HexabitzPlatform/H1BR7x-Hardware/README.md

# H1BR7x-Hardware
Hexabitz USB-C Mass Storage Device Module Hardware Design
