HexabitzPlatform/H1BR7x-Hardware/Released/BOM/H1BR7.xlsx

 |  | www.hexabitz.com info@hexabitz.com |  | Bill Of Materials
Customer | Hexabitz | Revision | 0
Project | Hexabitz Modules | Date | 27/12/2024
Board | USB-C Mass Storage Device (H1BR7) | Notes
Designator | Description | Manufacturer Part Number | Manufacturer | Octopart Url | Quantity
RESET | Headers & Wire Housings Unshrouded 1 POS T/H | 5-146280-1 | TE Connectivity | https://octopart.com/5-146280-1-te+connectivity+%2F+amp-40259676?r=sp | 1
PWR_EN | 2 Position Total Single Row 2.54 mm Pitch Straight Male Thru-Hole Header | M20-9990245 | HARWIN INC | https://octopart.com/m20-9990245-harwin-7492269?r=sp | 1
SWD | Conn Unshrouded Header HDR 3 POS 2.54mm Solder ST Top Entry Thru-Hole Carton | 5-146281-3 | TE Connectivity | https://octopart.com/5-146281-3-te+connectivity+%2F+amp-39745942?r=sp | 1
USB_C | CONN RCP USB3.1 TYPEC 24P SMD RA | 12401610E4#2A | Amphenol ICC | https://octopart.com/12401610e4%232a-amphenol+communications+solutions-126516878?r=sp | 1
J2 | 1.10mm Pitch microSD Memory Card Connector, Normal Mount Surface Mount | 502570-0893 | Molex | https://octopart.com/502570-0893-molex-42270318?r=sp | 1
R2 | RES SMD 0.0OHM JUMPER 1/10W 0603 | RC0603JR-070RL | YAGEO [VR] | https://octopart.com/rc0603jr-070rl-yageo-1241539?r=sp | 1
R4, R5 | Thick Film Resistors - SMD 0603 27ohms 5% AEC-Q200 | ERJ-3GEYJ270V | Panasonic | https://octopart.com/erj-3geyj270v-panasonic-55422052?r=sp | 2
R1 | Thick Film Resistors - SMD 0603 270 Ohm 5% Tol | ERJ-3GEYJ271V | Panasonic | https://octopart.com/erj-3geyj271v-panasonic-55560546?r=sp | 1
R7, R10, R11, R12 | 4.7 kOhms ±5% 0.1W, 1/10W Chip Resistor 0603 | RC0603JR-074K7L | YAGED [VA] | https://octopart.com/rc0603jr-074k7l-yageo-55458509?r=sp | 4
R3 , R6 | RES 10K Ohm 1% 0603 | RC0603FR-0710KL | Yageo | https://octopart.com/rc0603fr-0710kl-yageo-40025538?r=sp (https://octopart.com/crcw060310k0jneb-vishay+dale-46603268) | 2
C3, C4 | Multilayer Ceramic Capacitor, 47 pF, 50 V, ± 5%, C0G (NP0), 0603 [1608 Metric] | CL10C470JB8NNNC | Samsung | https://octopart.com/cl10c470jb8nnnc-samsung-9299382?r=sp | 2
C5, C6, C8, C10 | CAP CER 0.1 UF 25V 10% X7R 0603 | CL10B104KA8NNNC | Samsung Electro-Mechanics | https://octopart.com/cl10b104ka8nnnc-samsung-19831573?r=sp (https://octopart.com/c0603c104k8ractu-kemet-145075?r=sp&s=9bS9ASSwSEqMCE9KBEQZ0g) | 4
C2 | CAP CER 1 UF 16V X7R 0805 | CC0805KKX7R7BB105 | YAGEO [VA] | https://octopart.com/cc0805kkx7r7bb105-yageo-8376555?r=sp | 1
C11, C7 | CAP CER 4.7UF 16V X7R 0805 | C0805C475K4RACTU | KEMET [VA] | https://octopart.com/c0805c475k4ractu-kemet-22859922?r=sp (https://octopart.com/grm21bc81e475ka12l-murata-10331911?r=sp&s=RY3qZSD8T6mG6TC9CHI5qQ) | 2
C1, C9 | Cap Ceramic 10uF 25V X5R 10% Pad SMD 0805 | 08053D106KAT2A | AVX | https://octopart.com/08053d106kat2a-avx-71037153?r=sp | 2
FB1 | Ind chip Bead Multi-Layer 30 ohms 25% 100MHZ Ferrite 1,5A 0603Punched paper T/R | MMZ1608Y300BTA00 | TDK | https://octopart.com/mmz1608y300bta00-tdk-7906990?r=sp | 1
D1 | LED Uni-Color Super Red 639nm 2-Pin Chip 0603(1608Metric) T/R | VLMS1300-GS08 | Vishay | https://octopart.com/vlms1300-gs08-vishay-21709201?r=sp | 1
D2 | TVS DIODE 3,3V 10,9V SOD323 | CDSOD323-T03SC | Bourns | https://octopart.com/cdsod323-t03sc-bourns-10487153?r=sp | 1
U1 | MCU 32-bit ARM Cortex M0+ RISC 512KB Flash 1.8V/2.5V/3.3V 48-Pin UFQFPN EP Tray | STM32G0B1CEU6 | STMicroelectronics | https://octopart.com/stm32g0b1ceu6-stmicroelectronics-116363364?r=sp | 1
U2 | LDO Voltage Regulators 2 A high PSRR ultra low drop linear regulator reverse current protection | LD39200PU33R | STMicroelectronics | https://octopart.com/ld39200pu33r-stmicroelectronics-49646134?r=sp (https://octopart.com/max14840easa%2Bt-analog+devices-124208283?r=sp) | 1
X1 | 8,0000MHZ 33pF SMD MURATA Resonators | CSTNE8M00G550000R0 | Murata | https://octopart.com/cstne8m00g550000r0-murata-91406934?r=sp | 1
