HexabitzPlatform/H1BR7x-Hardware/Documentation/H1BR7 Schematics.pdf

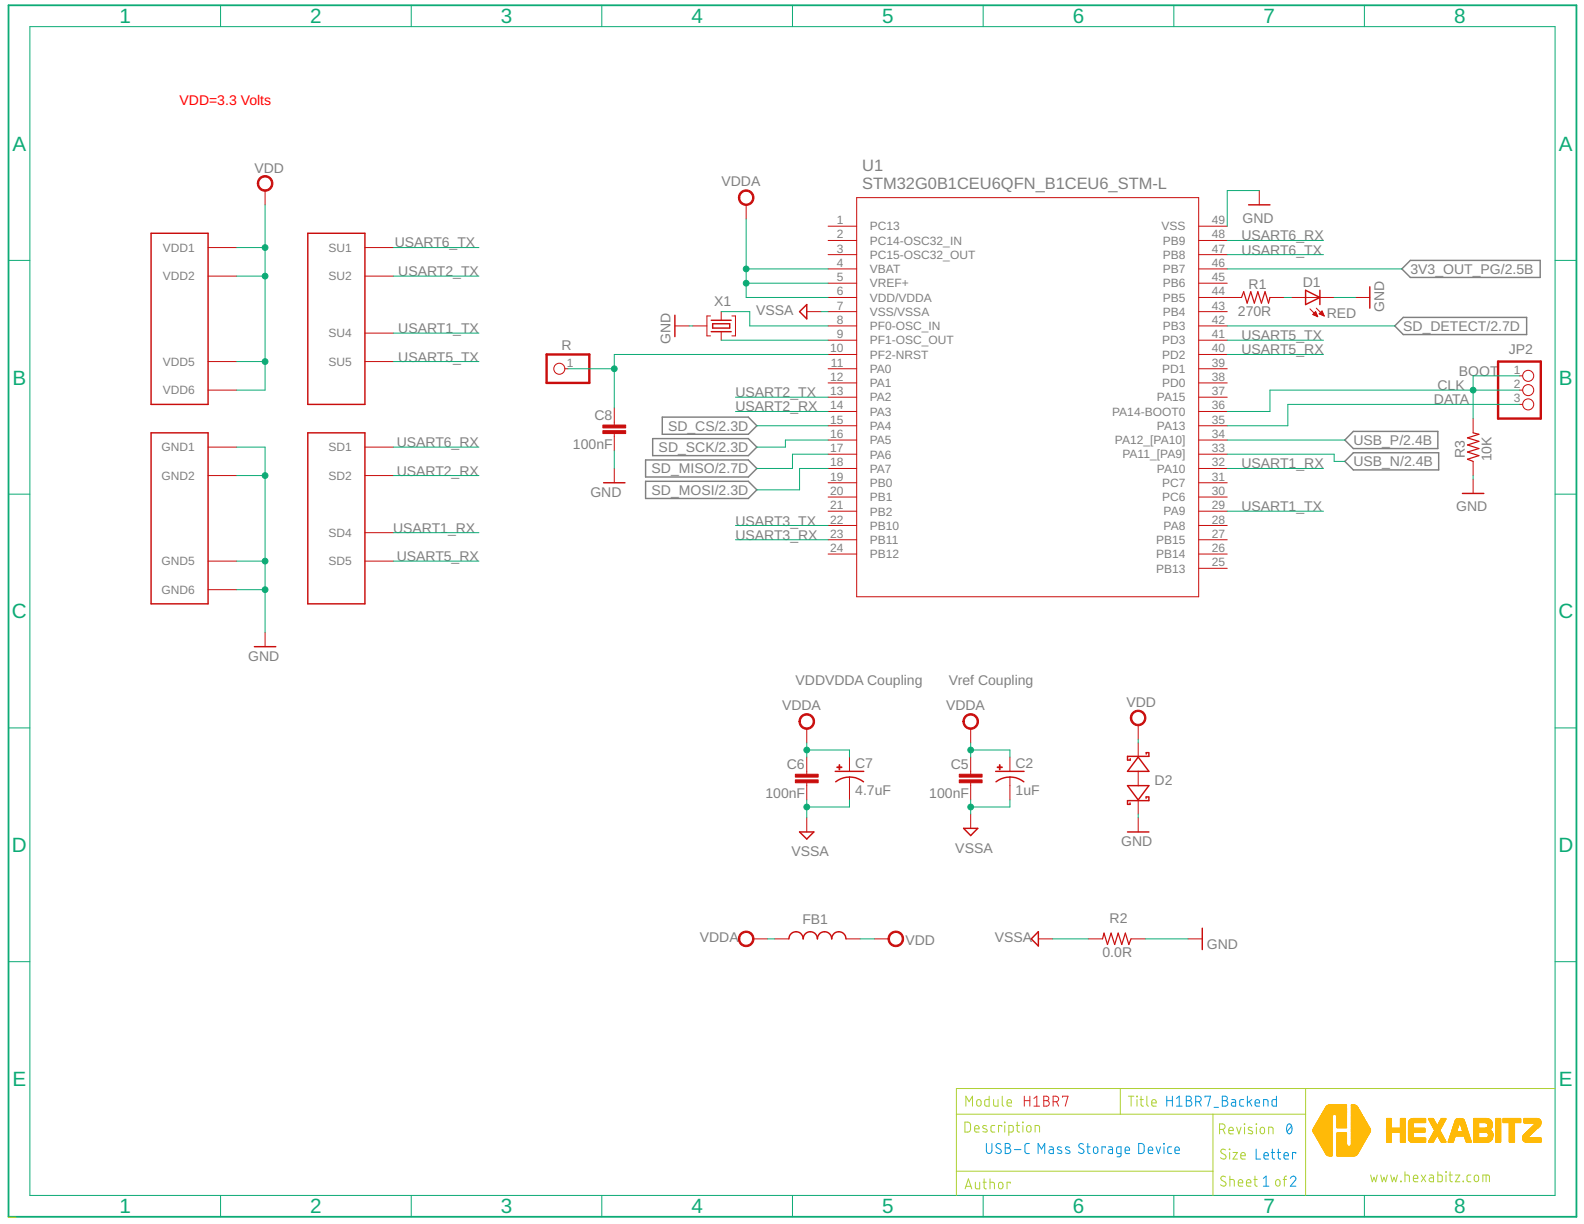
[picture p1: page 1]

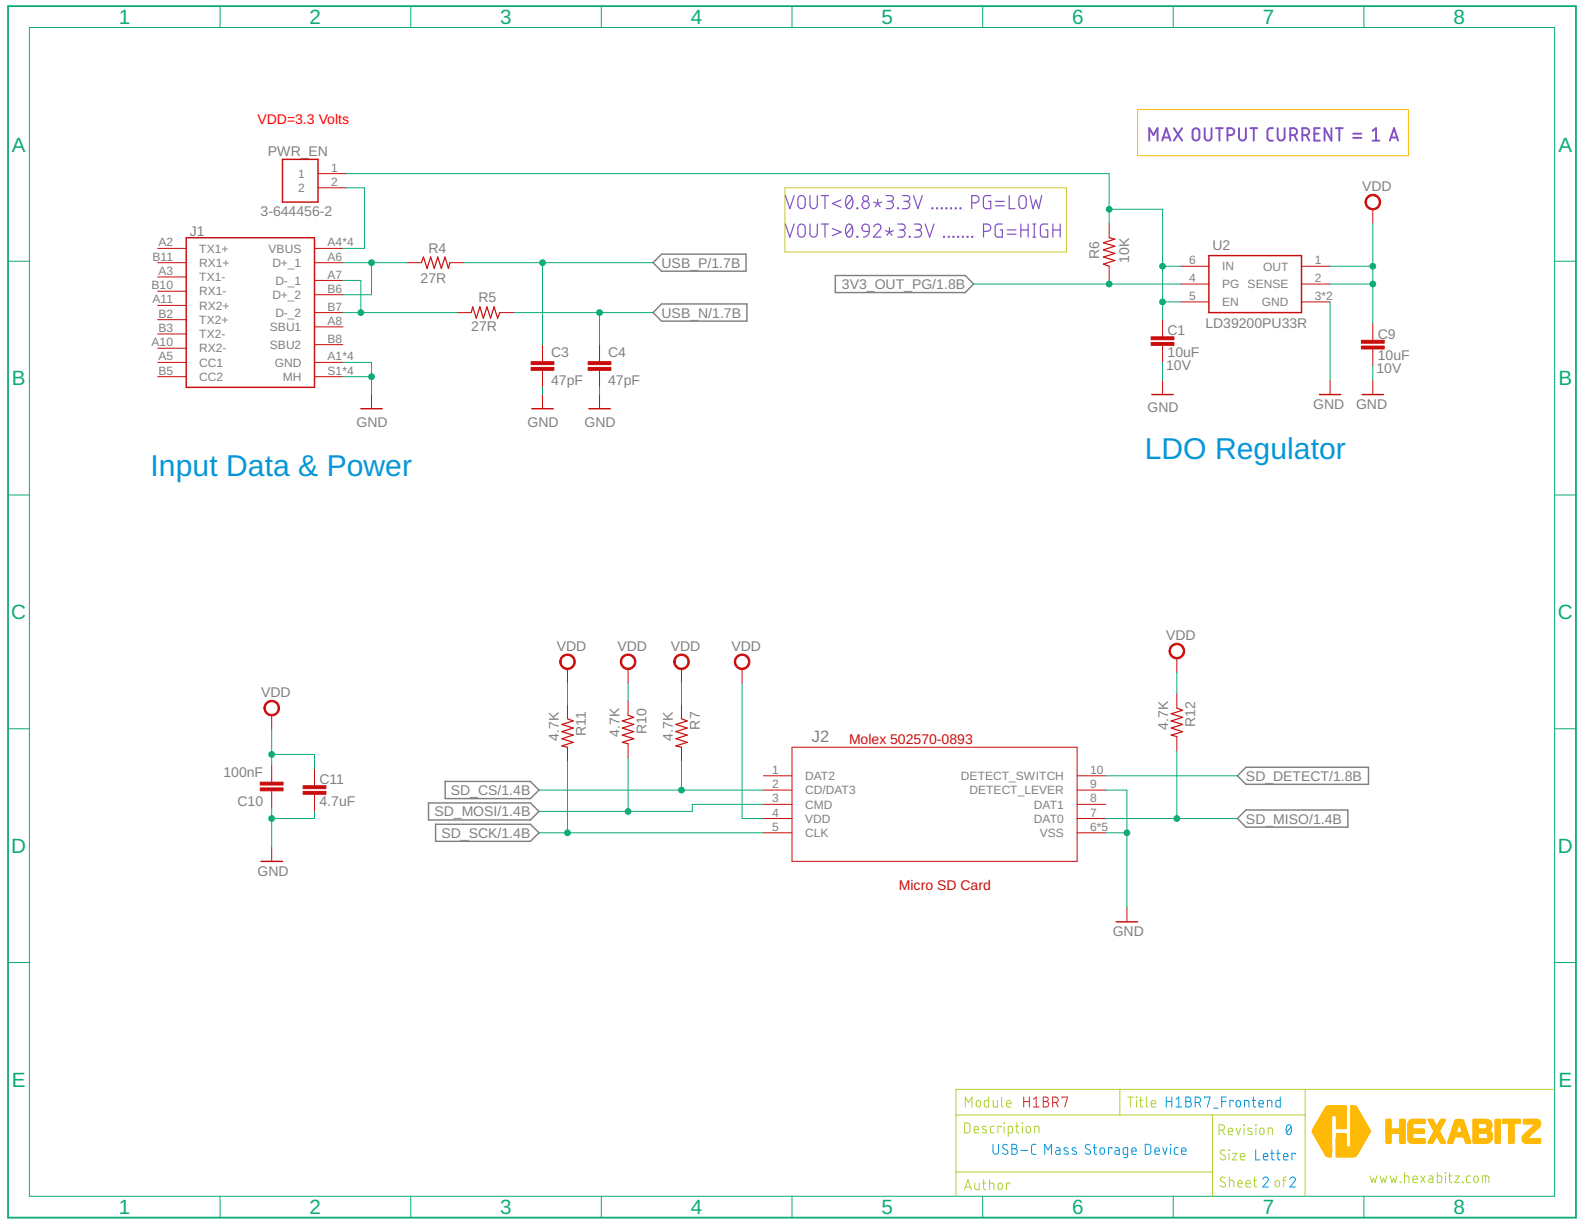
[picture p2: page 2]
