HexabitzPlatform/H1BR7x-Hardware/Design/H1BR7.brd

## EAGLE design Design/H1BR7.brd (2024-12-27)

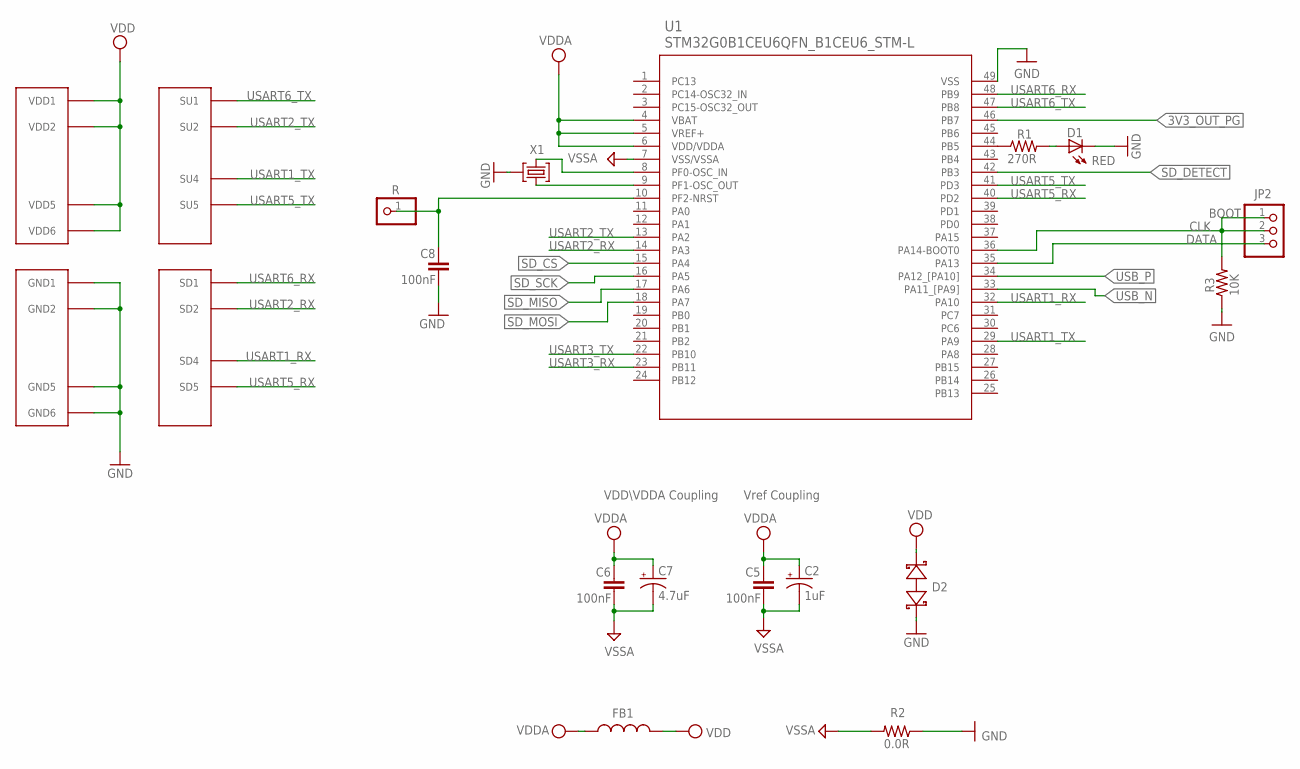
[picture p3: schematic H1BR7.sch, sheet 1]

Parts:
C2: 1uF; C-0805-POL
C5, C6, C8: 100nF; C-0603
C7: 4.7uF; C-0805-POL
D1: RED; VLMS1300-GS08; MPN VLMS1300-GS08
D2: BOURNS_CDSOD323-T03SCBOURNS_CDSOD323-T03SC_0_0; BOURNS_CDSOD323-T03SC_0
FB1: FB-TDK_MMZ1608Y300B; MPN MMZ1608Y300B
JP2: PINHD-1X3; 1X03
P1: HEXABIT_HEXABIT_?_NO_P3_P6_P9_P10; HEXABIT_?_NO_P3_P6_P9_P10
R: R; 1X01
R1: 270R; R-0603
R2: 0.0R; R-0603; MPN RC0603JR-070RL
R3: 10K; R-0603
TRIMBLE-LOGO1: HEXA-LOGO
U1: STM32G0B1CEU6QFN_B1CEU6_STM-L; QFN_B1CEU6_STM-L
X1: XTALL_CSTCE8M00G52

Connections:
3V3_OUT_PG: U1.46 (PB7); also elsewhere on the board
CLK: JP2.1, JP2.2, R3.2, U1.36 (PA14-BOOT0)
DATA: JP2.3, U1.35 (PA13)
GND: C8.2, D1.C, D2.1 (A), P1.PAD_PD7 (GND1), P1.PAD_PD8 (GND2), P1.PAD_PD11 (GND5), P1.PAD_PD12 (GND6), R2.1, R3.1, U1.49 (VSS), X1.P$2 (2); also elsewhere on the board
unnamed: R1.1, U1.44 (PB5)
unnamed: D1.A, R1.2
unnamed: C8.1, R.1, U1.10 (PF2-NRST)
unnamed: U1.9 (PF1-OSC_OUT), X1.P$1 (1)
unnamed: U1.8 (PF0-OSC_IN), X1.P$3 (3)
SD_CS: U1.15 (PA4); also elsewhere on the board
SD_DETECT: U1.42 (PB3); also elsewhere on the board
SD_MISO: U1.17 (PA6); also elsewhere on the board
SD_MOSI: U1.18 (PA7); also elsewhere on the board
SD_SCK: U1.16 (PA5); also elsewhere on the board
USART1_RX: P1.PAD_PD4 (SD4), U1.32 (PA10)
USART1_TX: P1.PAD_PU4 (SU4), U1.29 (PA9)
USART2_RX: P1.PAD_PD2 (SD2), U1.14 (PA3)
USART2_TX: P1.PAD_PU2 (SU2), U1.13 (PA2)
USART3_RX: U1.23 (PB11)
USART3_TX: U1.22 (PB10)
USART5_RX: P1.PAD_PD5 (SD5), U1.40 (PD2)
USART5_TX: P1.PAD_PU5 (SU5), U1.41 (PD3)
USART6_RX: P1.PAD_PD1 (SD1), U1.48 (PB9)
USART6_TX: P1.PAD_PU1 (SU1), U1.47 (PB8)
USB_N: U1.33 (PA11_[PA9]); also elsewhere on the board
USB_P: U1.34 (PA12_[PA10]); also elsewhere on the board
VDD: D2.2 (C), FB1.2, P1.PAD_PU7 (VDD1), P1.PAD_PU8 (VDD2), P1.PAD_PU11 (VDD5), P1.PAD_PU12 (VDD6); also elsewhere on the board
VDDA: C2.1 (+), C5.1, C6.1, C7.1 (+), FB1.1, U1.4 (VBAT), U1.5 (VREF+), U1.6 (VDD/VDDA)
VSSA: C2.2 (-), C5.2, C6.2, C7.2 (-), R2.2, U1.7 (VSS/VSSA)

Notes on the sheet:
Vref Coupling
VDD\VDDA Coupling
BOOT

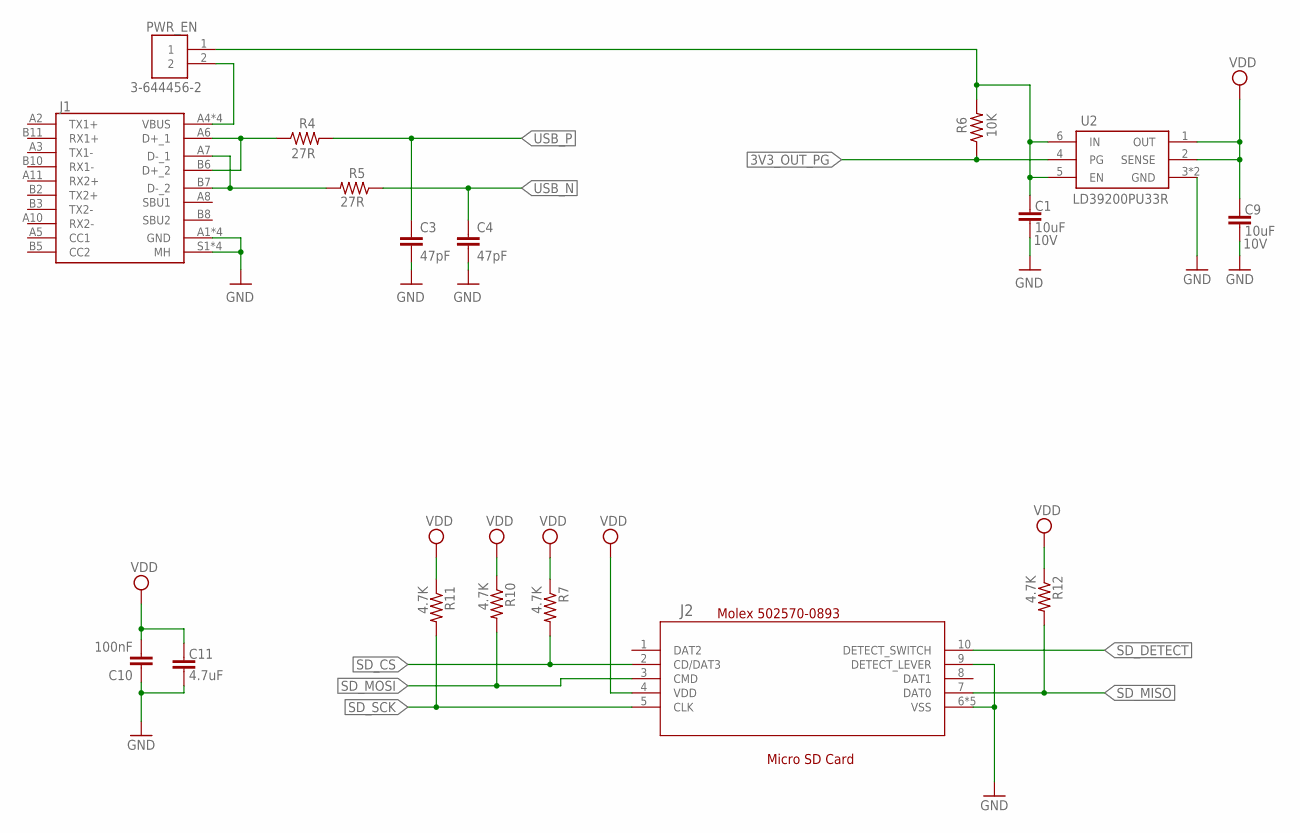
[picture p4: schematic H1BR7.sch, sheet 2]

Parts:
C1, C9: 10uF; C-0805; VOLTAGE_RATING 10V; MPN GRM187R61A226ME15
C3, C4: 47pF; C-0603
C10: 100nF; C-0603; TOLERANCE 10%; VOLTAGE_RATING 16.0 V; MPN '0603YC104K4T2A
C11: 4.7uF; C-0805; VOLTAGE_RATING 10V; MPN GRM187R61A226ME15
J1: 12401610E4#2A12401610E42A; AMPHENOL_12401610E4_2A
J2: 5025700893502570-0893_MOL; 502570-0893_MOL
PWR_EN: 3-644456-2; TE_3-644456-2
R4, R5: 27R; R-0603; TOLERANCE 1%
R6: 10K; R-0603; TOLERANCE 1%
R7, R10, R11, R12: 4.7K; R-0603; TOLERANCE 5%; MPN RC0603JR-074K7L
U2: LD39200PU33R; SON95P300X300X100-7N

Connections:
3V3_OUT_PG: R6.1, U2.4 (PG); also elsewhere on the board
D_N: J1.A7 (D-_1), J1.B7 (D-_2), R5.2
D_P: J1.A6 (D+_1), J1.B6 (D+_2), R4.1
GND: C1.1, C3.2, C4.2, C9.1, C10.1, C11.1, J1.A1 (GND), J1.A12 (GND), J1.B1 (GND), J1.B12 (GND), J1.S1 (MH), J1.S2 (MH), J1.S3 (MH), J1.S4 (MH), J2.6 (VSS), J2.9 (DETECT_LEVER), J2.11 (VSS), J2.12 (VSS), J2.13 (VSS), J2.14 (VSS), U2.3 (GND), U2.7 (GND); also elsewhere on the board
unnamed: C1.2, PWR_EN.1, R6.2, U2.5 (EN), U2.6 (IN)
unnamed: J1.A4 (VBUS), J1.A9 (VBUS), J1.B4 (VBUS), J1.B9 (VBUS), PWR_EN.2
SD_CS: J2.2 (CD/DAT3), R7.2; also elsewhere on the board
SD_DETECT: J2.10 (DETECT_SWITCH); also elsewhere on the board
SD_MISO: J2.7 (DAT0), R12.2; also elsewhere on the board
SD_MOSI: J2.3 (CMD), R10.2; also elsewhere on the board
SD_SCK: J2.5 (CLK), R11.2; also elsewhere on the board
USB_N: C4.1, R5.1; also elsewhere on the board
USB_P: C3.1, R4.2; also elsewhere on the board
VDD: C9.2, C10.2, C11.2, J2.4 (VDD), R7.1, R10.1, R11.1, R12.1, U2.1 (OUT), U2.2 (SENSE); also elsewhere on the board

Notes on the sheet:
Micro SD Card
Molex 502570-0893

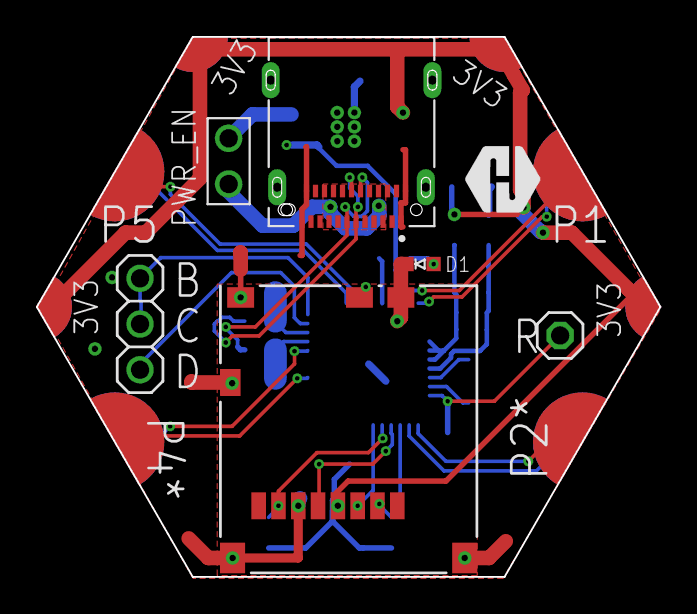
[picture p5: board H1BR7.brd from above]

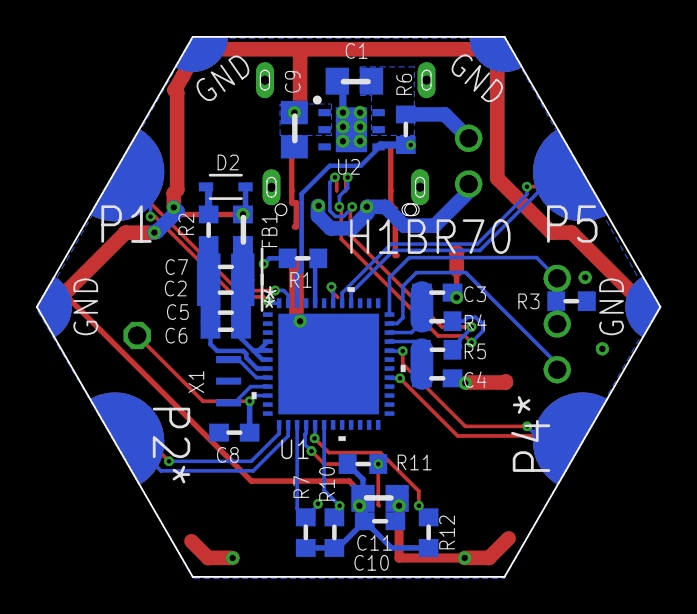
[picture p6: board H1BR7.brd from below]

Board: 2 copper layers, 34.6 x 30.0 mm, 34 parts (26 on the bottom side), 31 nets.
