HexabitzPlatform/H1BR7x-Hardware/(notices)

Notices in the files:
parts and their libraries:
HEXABITZ_ICs: COPYRIGHT: Copyright (C) 2021 Ultra Librarian. All rights reserved.
HEXABITZ_CONNECTION_PARTS: COPYRIGHT: Copyright (C) 2022 Ultra Librarian. All rights reserved.
